matthewsdjr/esp32-monitoreo/(commit log)

2026-08-12 Fase 1 (backend) y Fase 4 (dashboard) del sistema de monitoreo ESP32
    Arquitectura de doble ruta: el ESP32 publica hacia afuera (Supabase) y el
    dashboard se suscribe, porque GitHub Pages no puede consultar una IP privada
    detrás de NAT ni hacer fetch a http:// desde https://.
    Backend (verificado con 30 aserciones sobre Postgres real):
    - Esquema, RLS de solo lectura para anon, canal Realtime privado
    - Motor de alarmas con histéresis y duración mínima
    - Edge Functions /ingest y /notify
    - Rollups a 5 min y purga con pg_cron
    Dashboard (Vite + React + TS):
    - Modo demo integrado: funciona sin backend ni hardware
    - Paleta validada para daltonismo, tema claro/oscuro, vista de tabla
    - Una escala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
2026-08-12 Corregir encimado de la insignia de estado en tarjetas angostas
    En pantallas de ~1280 px la insignia "Fuera de rango objetivo" se montaba
    sobre el título en las tarjetas de termopar.
    - Cabecera con flex-wrap: la insignia baja de renglón en vez de encimarse
    - Etiqueta breve para la insignia; el texto completo queda en el lector de
    pantalla y en la evaluación
    - Las 5 columnas ahora requieren 2xl (1536 px), no xl (1280 px)
    Verificado con emulación de dispositivo: scrollWidth == viewport a 390 px,
    sin desbordamiento horizontal.
2026-08-13 Documentar la URL pública del dashboard
2026-08-13 Panel de conectividad del equipo y tara remota con PIN
    El modo demostración devolvía estado "online" con RSSI inventado, así que la
    página mostraba un indicador verde de "En línea" con datos moviéndose. Cualquiera
    concluía que su ESP32 estaba reportando. Una simulación no debe ser
    indistinguible de la realidad en un panel de operación.
    - Modo demo declarado como tal: "nunca conectado", sin métricas falsas, y las
    órdenes se rechazan en vez de fingir éxito
    - Panel de conexión: internet, calidad de señal, uptime, memoria; cuando el
    equipo nunca ha reportado, lista qué revisar y en qué orden
    - Canal de comandos: los comandos cruzan el NAT en la respuesta al POST del
    propio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
2026-08-13 Fase 2: refactor del firmware y drivers de sensores
    Reemplaza el prototipo por una arquitectura que sostiene operación en red.
    Compila para ESP32 (22 KB RAM, 313 KB flash) y pasa 74 aserciones en el host.
    Correcciones sobre el prototipo:
    - get_units(10) bloqueaba ~1 s esperando 10 conversiones a 10 SPS. Con la pila
    de red activa eso basta para tirar la conexión TLS. Ahora se lee solo cuando
    el HX711 señala dato listo: ~60 µs.
    - El bit-banging del HX711 va en sección crítica. El chip se APAGA si su reloj
    queda en alto más de 60 µs, y el planificador puede expropiar la tarea a mitad
    de un pulso. El síntoma sería basura ocasional imposible de reproducir.
    - readCelsius() sin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
2026-08-13 Documentar el firmware en el README
2026-08-13 Fase 3: red, búfer offline, comandos remotos y OTA
    Compila para ESP32 (81 KB RAM, 1.1 MB flash) y pasa 90 aserciones en el host.
    El equipo ya publica por las dos rutas del contrato y ejecuta la tara remota.
    Decisiones que vale la pena conocer:
    UNA SOLA CONEXIÓN TLS para ambas rutas. El saludo TLS cuesta 1-2 s y ~45 KB de
    heap en un ESP32: rehacerlo cada 2 s es imposible, y dos sockets simultáneos
    dejan el heap al límite. Ambas rutas van al mismo host, así que se serializan
    sobre un socket con keep-alive.
    EL BÚFER GUARDA MARCAS MONÓTONAS, no épocas. El ESP32 arranca sin saber la
    fecha; convertir al publicar permite que las muestras capturadas antes del NTP
    recuperen su hora real en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
2026-08-14 Backend en producción y correcciones que salieron de integrarlo
    Umbral de obsolescencia según el modo de enlace. Estaba fijo en 15 s, que
    corresponde a la cadencia de 2 s del canal en vivo. Cuando el navegador cae a
    consulta periódica, el dato más fresco es el del último lote (cada 30 s), así
    que TODAS las tarjetas se marcaban obsoletas de forma permanente aunque el
    sistema funcionara bien. Ahora 95 s en modo degradado: tres lotes perdidos.
    generar-ca.sh embebía el último certificado de la cadena servida, pero los
    servidores suelen enviar la raíz CON FIRMA CRUZADA, que no sirve como ancla de
    confianza: no es auto-firmada y la validación busca a SU emisor y falla.
    Verificado empír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
2026-08-14 Prueba de seguridad del canal en vivo, verificada contra producción
    El endpoint de broadcast responde 202 ("encolado") ANTES de evaluar la
    autorización, así que el código HTTP no prueba nada: con la anon key, con el
    JWT de otro equipo y con el JWT legítimo, los tres devuelven 202.
    La prueba se suscribe al canal y comprueba qué llega de verdad. Resultado
    contra el proyecto real:
    ✓ el equipo legítimo publica y se entrega
    ✓ la anon key NO puede publicar (se descarta en silencio)
    ✓ el JWT de otro equipo NO puede publicar en este canal
    Es la propiedad que sostiene todo el canal en vivo: la anon key va incrustada
    en el bundle del dashboard y cualquiera puede extraerla, así q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
2026-08-14 Aprovisionamiento por puerto serie y guía de puesta en marcha
    El JWT del equipo son ~256 caracteres y el token ~43. Teclear eso en el
    formulario del portal cautivo desde un celular es impracticable, y es donde se
    cometen los errores de transcripción que después cuestan una hora de
    diagnóstico. Ahora se pueden pegar por USB con copiar-pegar.
    - Comandos `set`, `ver` y `olvidar` en la consola serie
    - El portal cautivo atiende el puerto serie mientras está abierto, así que
    ambas vías conviven y quien configura elige
    - El búfer de línea pasa de 64 a 512 caracteres: con 64 el JWT se truncaba en
    silencio, que es la peor forma de fallar
    - lineas-aprovisionamiento.mjs imprime las línea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
    [config.h, main.cpp]
2026-08-14 Corregir dos bugs de aprovisionamiento hallados con el equipo real
    Ambos aparecieron al configurar el ESP32 físico y ninguno se habría visto sin
    hardware:
    1. El portal salía en cuanto la configuración era MÍNIMAMENTE completa. Como el
    JWT y la anon key se envían después del token, se perdían: el equipo quedaba
    operativo pero sin tiempo real, y el `ver` mostraba ambos campos vacíos sin
    explicar por qué. Ahora solo se sale con `r` explícito.
    2. `set ssid` escribía la contraseña desde una variable temporal que aún estaba
    vacía, borrando una contraseña ya guardada. Los dos campos se guardan ahora
    por separado.
    Además `ver` informa si la contraseña WiFi está c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
    [aprovisionar.py, main.cpp]
